saqibakhlaq7/Drone/images/camera_cradle.png

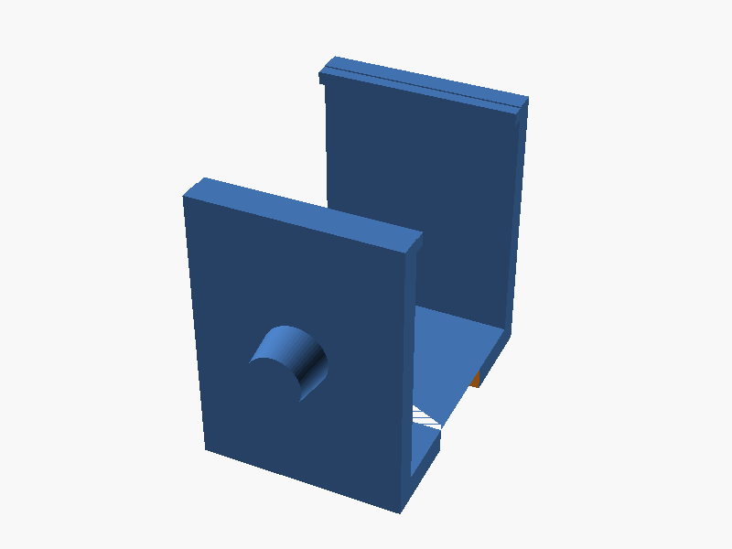
images/camera_cradle.png
