saqibakhlaq7/Drone/images/hub.png

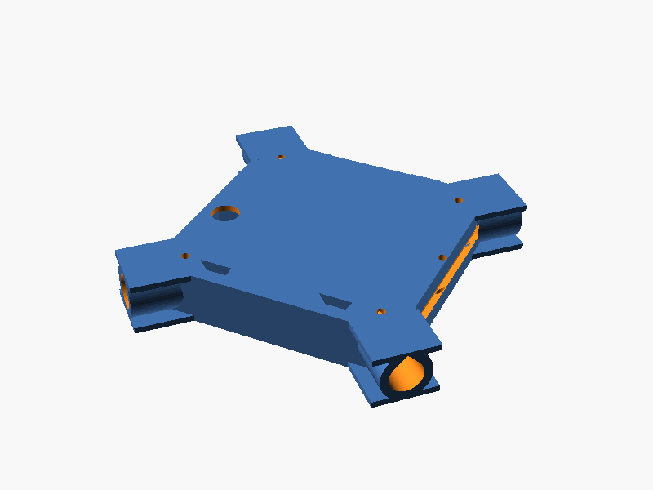
images/hub.png
