saqibakhlaq7/Drone/stl/stack_peg.stl

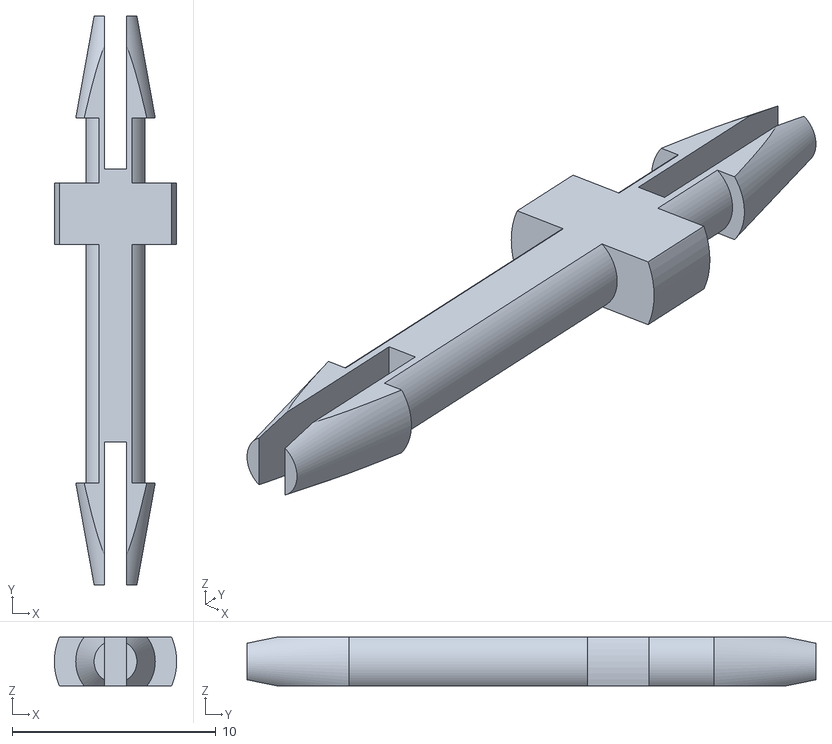
[picture p13: CAD file, 2026-10-11]
stl/stack_peg.stl
6.00 x 27.9 x 2.40
