saqibakhlaq7/Drone/stl/stack_spacer.stl

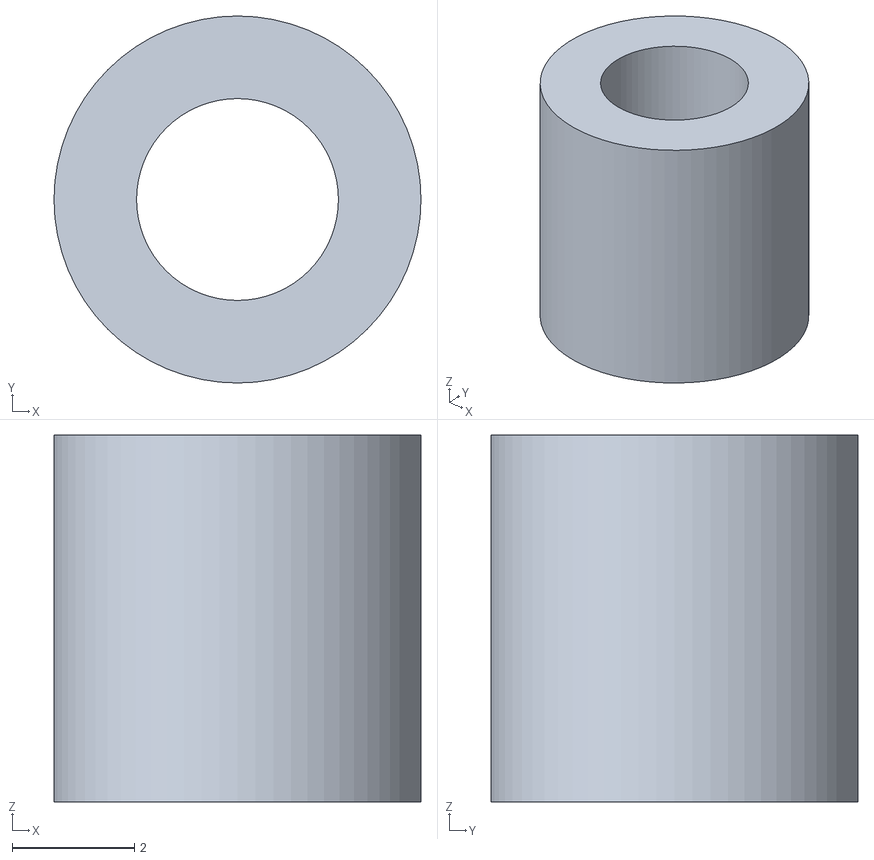
[picture p14: CAD file, 2026-10-11]
stl/stack_spacer.stl
6.00 x 6.00 x 6.00
