saqibakhlaq7/Drone/stl/camera_mount.stl

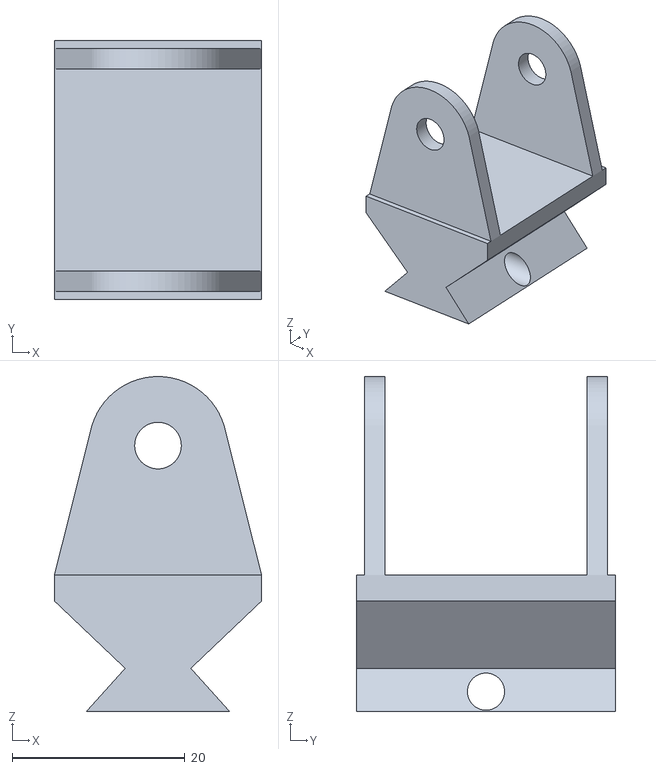
[picture p15: CAD file, 2026-10-11]
stl/camera_mount.stl
24.0 x 30.0 x 38.8
