saqibakhlaq7/Drone/stl/leg.stl

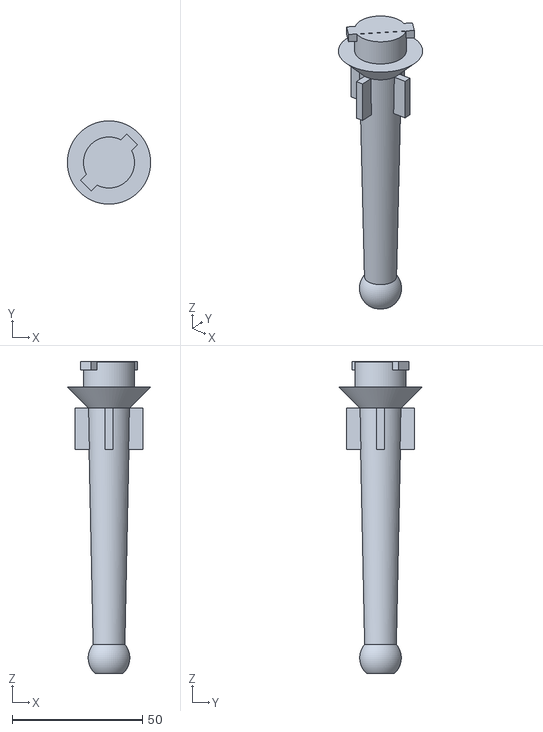
[picture p16: CAD file, 2026-10-11]
stl/leg.stl
32.0 x 32.0 x 119.8
