saqibakhlaq7/Drone/stl/pin_mount.stl

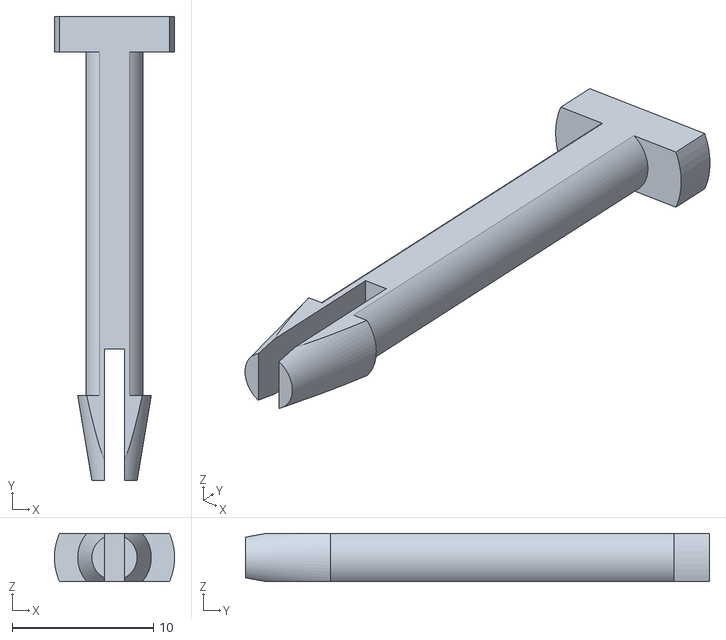
[picture p17: CAD file, 2026-10-11]
stl/pin_mount.stl
8.50 x 32.8 x 3.40
