saqibakhlaq7/Drone/stl/motor_mount.stl

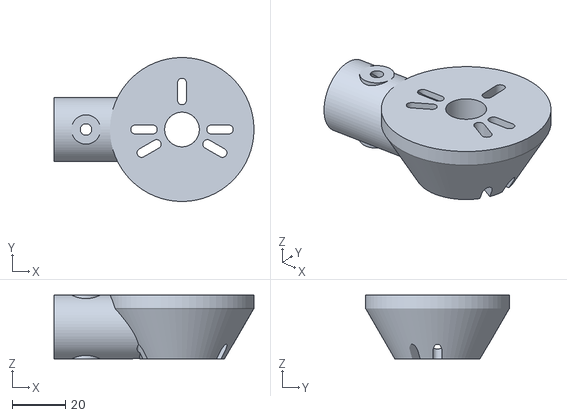
[picture p18: CAD file, 2026-10-11]
stl/motor_mount.stl
75.0 x 54.0 x 24.0
