saqibakhlaq7/Drone/stl/camera_cradle.stl

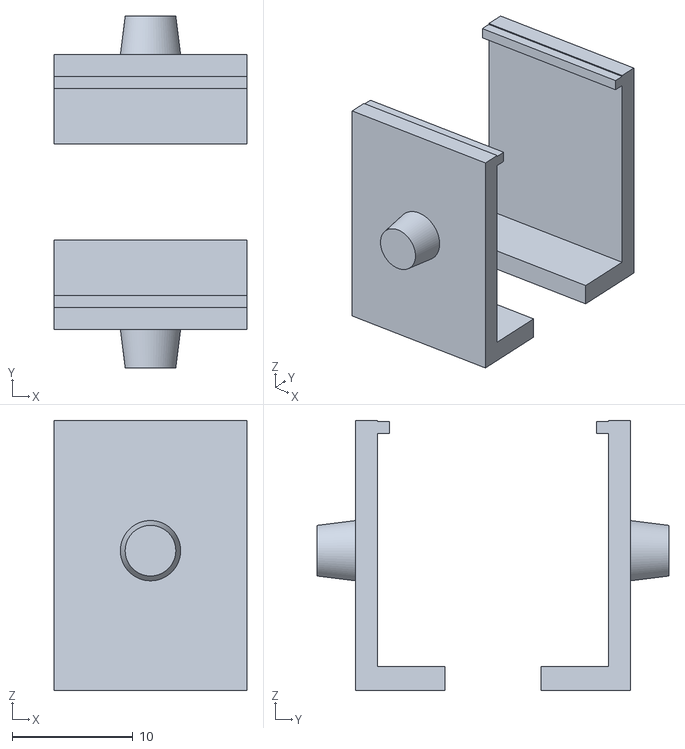
[picture p19: CAD file, 2026-10-11]
stl/camera_cradle.stl
16.0 x 29.2 x 22.4
