saqibakhlaq7/Drone/stl/hub.stl

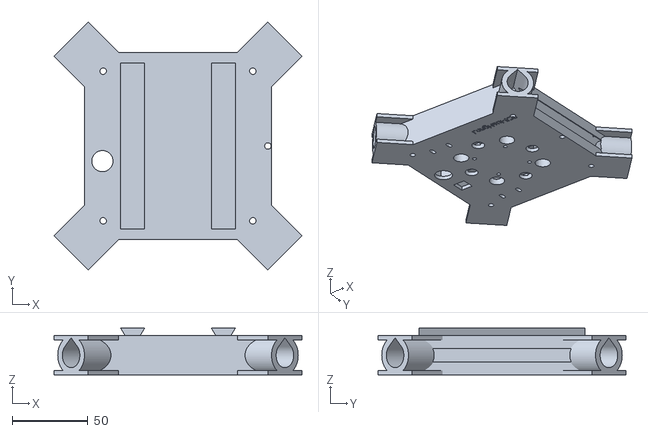
[picture p20: CAD file, 2026-10-11]
stl/hub.stl
164.0 x 164.0 x 31.0
