saqibakhlaq7/Drone/stl/battery_tray.stl

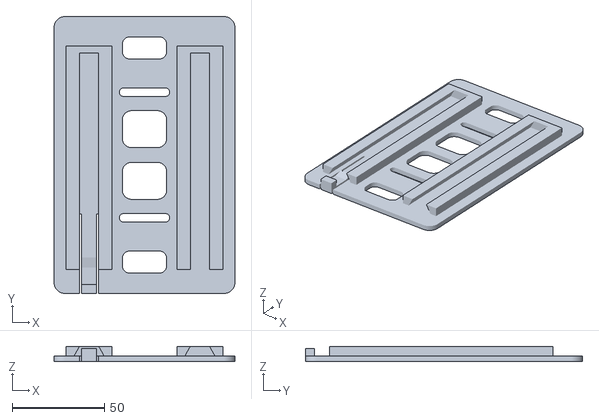
[picture p21: CAD file, 2026-10-11]
stl/battery_tray.stl
98.0 x 150.0 x 8.30
