saqibakhlaq7/Drone/stl/gps_mast.stl

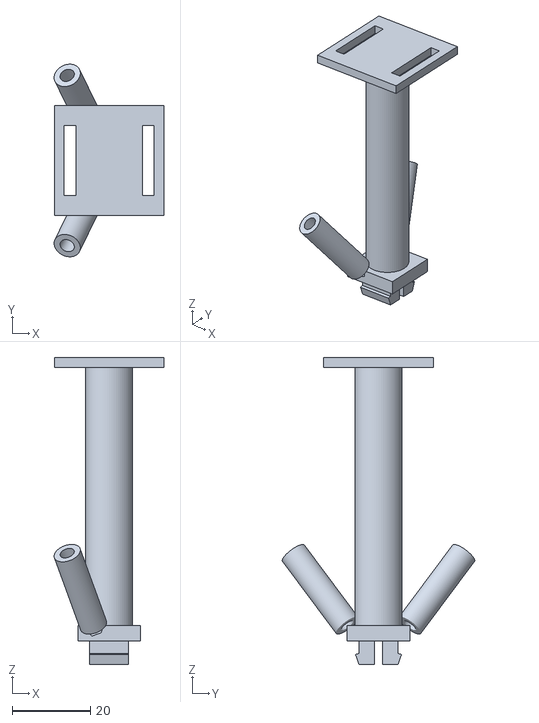
[picture p22: CAD file, 2026-10-11]
stl/gps_mast.stl
28.1 x 49.3 x 78.5
