saqibakhlaq7/Drone/stl/pin_hub.stl

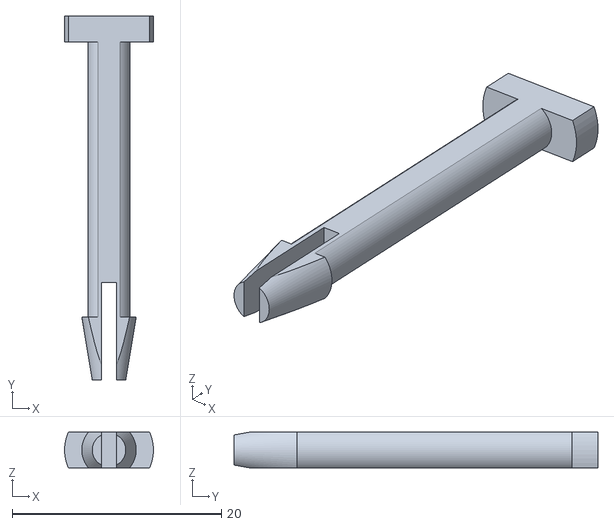
[picture p23: CAD file, 2026-10-11]
stl/pin_hub.stl
8.50 x 34.8 x 3.40
