saqibakhlaq7/Drone/(list of files, cad)

Other CAD files:
dxf/longhaul520_drawings.dxf
dxf/parts/battery_tray.dxf
dxf/parts/camera_cradle.dxf
dxf/parts/camera_mount.dxf
dxf/parts/gps_mast.dxf
dxf/parts/hub.dxf
dxf/parts/leg.dxf
dxf/parts/motor_mount.dxf
dxf/parts/pin_hub.dxf
dxf/parts/pin_mount.dxf
dxf/parts/stack_peg.dxf
dxf/parts/stack_spacer.dxf
