saqibakhlaq7/Drone/images/assembly_side.png

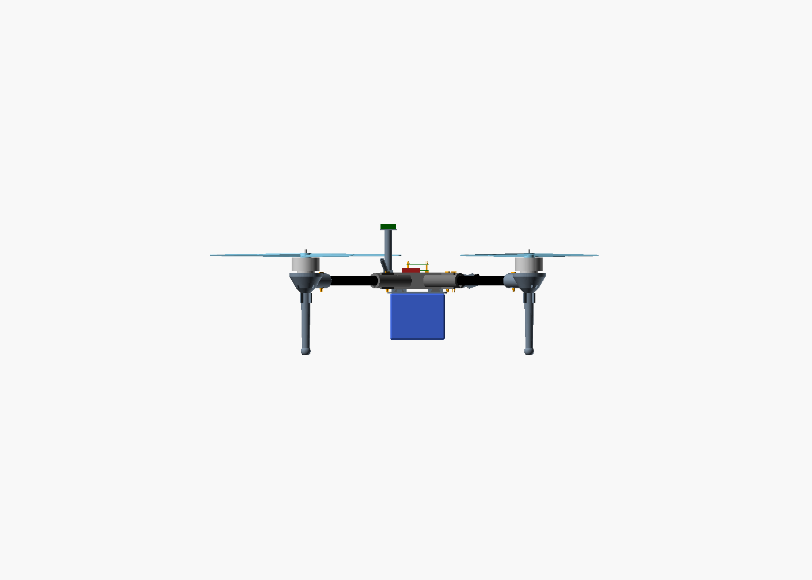
images/assembly_side.png
