saqibakhlaq7/Drone/(commit log)

2026-10-11 Add LongHaul-520: 3D-printable 1-hour camera quad with Amazon.in parts list
    Parametric OpenSCAD frame (printed hub, motor mounts, legs, battery tray,
    camera mount, GPS mast + 16 mm carbon tube arms), exported STLs and
    previews, endurance calculator, Amazon India BOM and full build guide.
    Claude-Session: https://claude.ai/code/session_01QZQZcbzmdNQHJwE9GTgrQH
    [battery_tray.stl, camera_mount.stl, gps_mast.stl, hub_bottom.stl, hub_top.stl, leg.stl, longhaul_quad.scad, motor_mount.stl]
2026-10-11 v2: screwless frame, DXF drawing set and assembled USDZ model
    Replace every bolted frame joint with printed joints: one-piece hub with
    slide-in arm sockets and snap pins, bayonet legs, dovetail battery tray
    with flexure latch, dovetail camera mount with snap cradle, snap-fit GPS
    mast and FC stack pegs. Only the motors keep their supplied screws.
    Add tools/make_models.py to generate dxf/longhaul520_drawings.dxf
    (front/top/right views, per-component layers, all parts, dimensions,
    title block), per-part DXF outlines, and models/longhaul520_assembled.usdz.
    Update docs, weight budget and preview images.
    Claude-Session: https://claude.ai/co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
    [battery_tray.dxf, battery_tray.stl, camera_cradle.dxf, camera_cradle.stl, camera_mount.dxf, camera_mount.stl, gps_mast.dxf, gps_mast.stl]
2026-10-12 Add physics-based take-off/landing animation (web scene, recorder, sound synth)
    animation/: three.js scene flying the real CAD model (drone.glb) with a
    small flight model - RPM-based thrust, motor lag, ground effect, landing
    gear spring, altitude controller on a min-jerk profile, wind + GPS hold -
    plus rotor-wash dust, prop blur discs, telemetry HUD and cinematic camera.
    record.cjs renders it frame by frame; tools/make_video.py synthesises
    sound from the simulated RPM and encodes the MP4. make_models.py now also
    exports drone.glb (with normals).
    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
2026-10-12 Add rendered take-off/landing video and poster frame
    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
